Arkiralor/PlayNRecordArm/BLOCKDIAGRAM.png

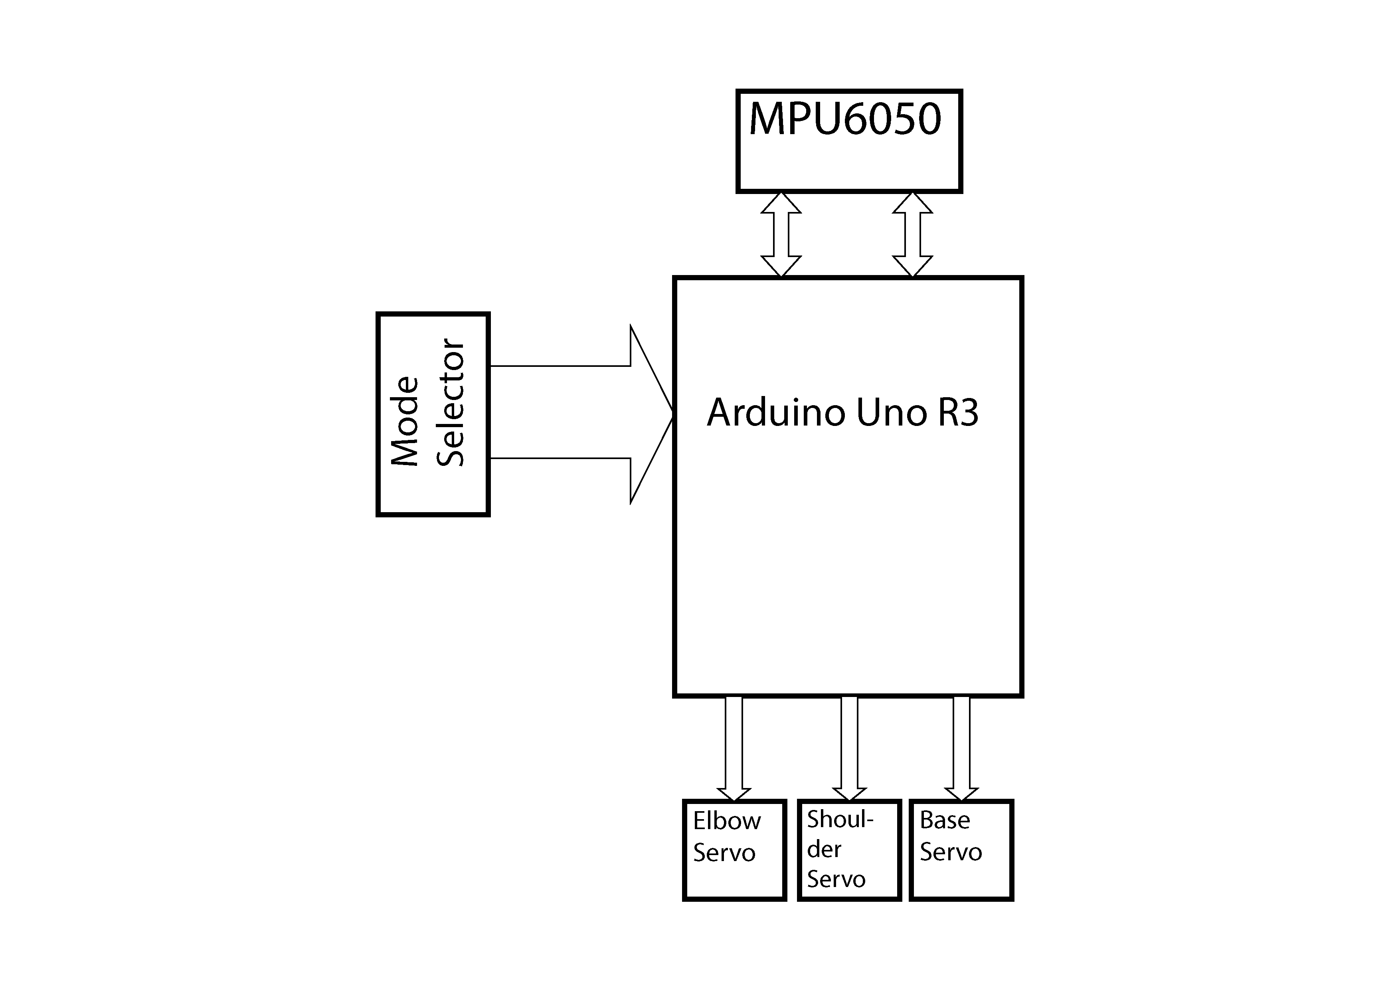
BLOCKDIAGRAM.png
