Arkiralor/PlayNRecordArm/Schematic_Gyro-Trainable-Arm_Sheet-1_20190705072949.pdf

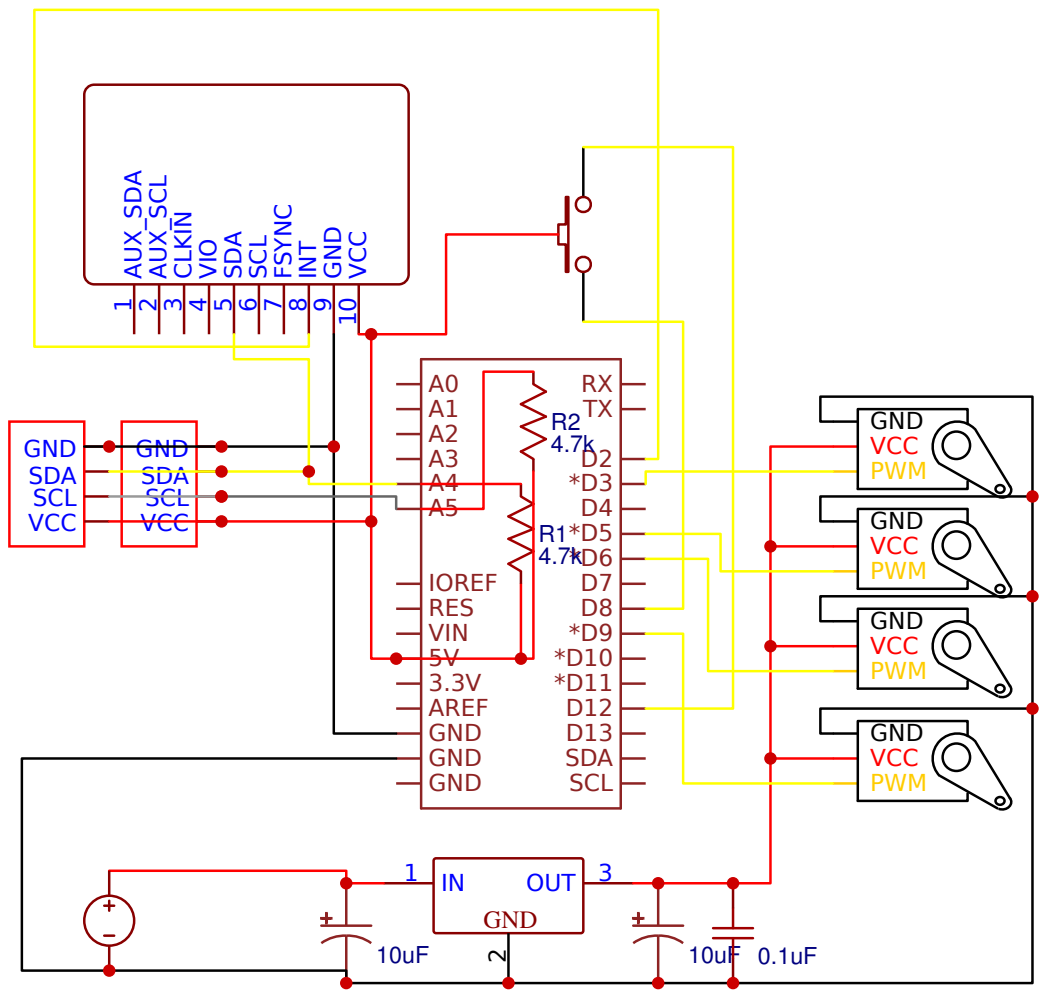
[picture p2: page 1]
