Arkiralor/PlayNRecordArm/(commit log)

2019-06-28 Add files via upload
    Uploaded the Circuit Diagram and the Logical Block Diagram of the project.
2019-06-28 Update PlugNPlay.ino
    Fixed mathematical formula to pass angular orientation to servos.
    [PlugNPlay.ino]
2019-07-06 Added Gerber files for PCB for the arm with added functionalities.
    Added the Gerber files for an Arduino shield that will form the circuit as described in the diagram and also add additional functionalities. Code will follow shortly, as well as an updated circuit diagram.
2019-07-06 Added updated circuit diagram.
    The mentioned circuit can be constructed using the included PCB Gerber files.
2019-07-06 Added Parts List
    [Custom Shield_001 - BOM.xlsx]
